Josephts1/Proyecto_diseno/README.md

En este repositorio se encuentra el contenido desarrollado para el proyecto final de la materia Diseño de Circuitos Electrónicos.
Universidad Industrial de Santander 2024.
