Josephts1/Proyecto_diseno/(list of files, drawings)

Other design files:
Archivo Proteus/Diseno_PCB.pdsprj
